pdaxrom/pico-hd6303/hw/pico-hd6303.brd

## EAGLE design hw/pico-hd6303.brd (2023-06-01)

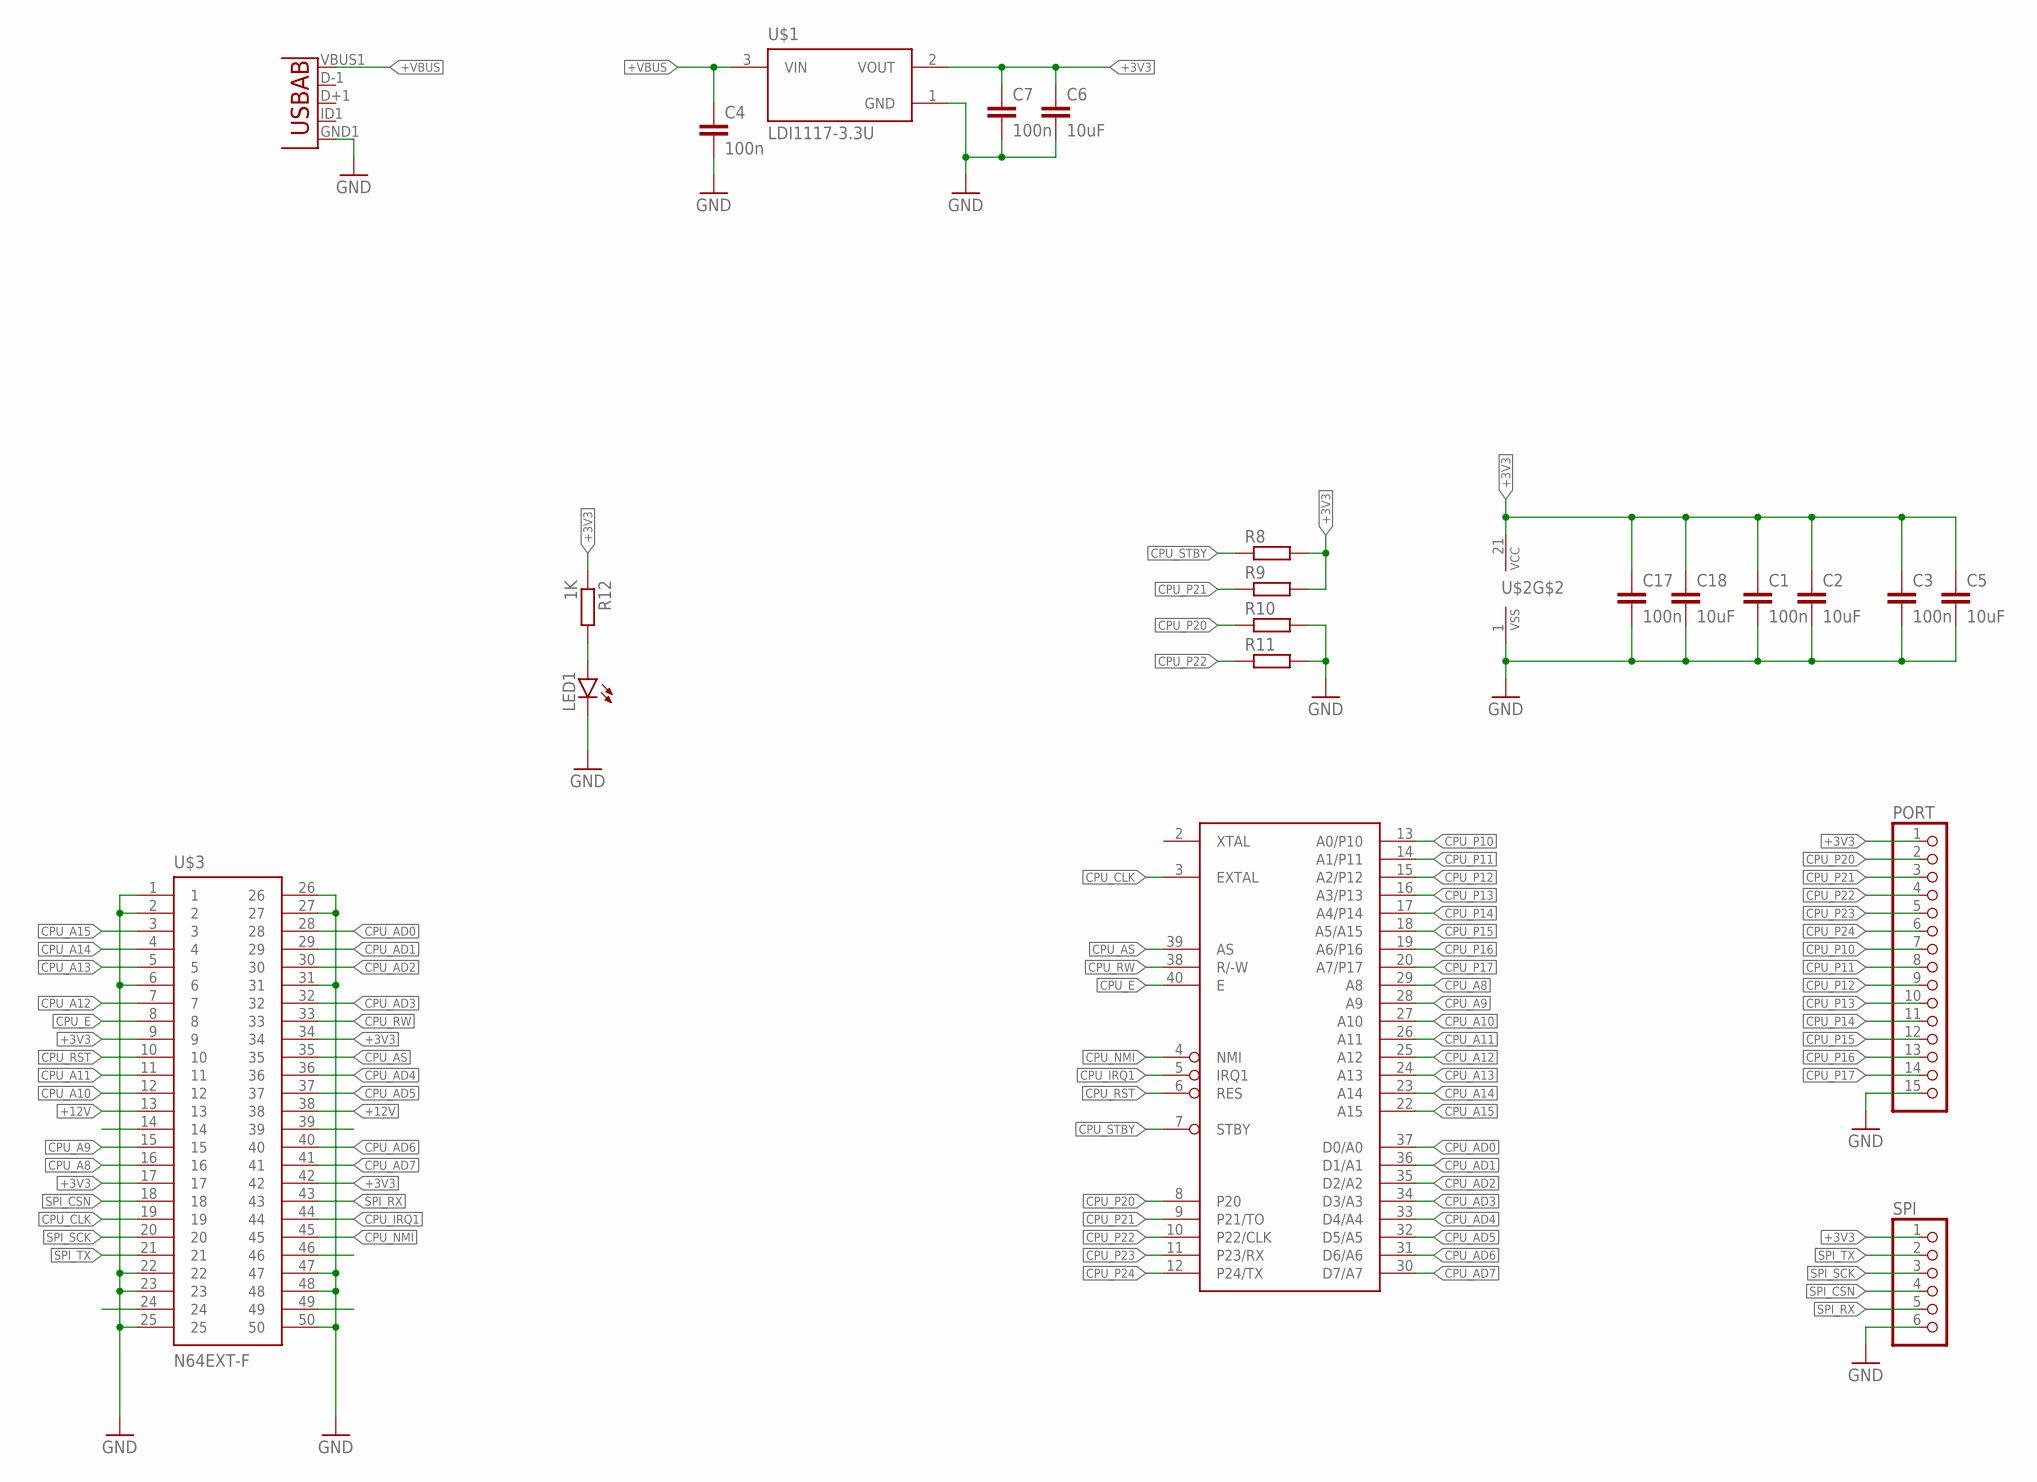
[picture p1: schematic pico-hd6303.sch]

Parts:
C1, C3, C17: 100n; C0603
C2, C5, C6, C18: 10uF; C0805
C4, C7: 100n; C0402
LED1: LED5MM
PORT: PINHD-1X15; 1X15
R8, R9, R10, R11: R-EU_R0603; R0603
R12: 1K; R0603
SPI: PINHD-1X6; 1X06
U2: USB""; USB-MICRO-SMD
U$1: LDI1117-3.3U
U$2: HD63B03PRP; DIL40
U$3: N64EXT-F; N64F

Connections:
+3V3: C1.1, C2.1, C3.1, C5.1, C6.1, C7.1, C17.1, C18.1, PORT.1, R8.2, R9.2, R12.1, SPI.1, U$1.2 (VOUT), U$2.21 (VCC), U$3.9, U$3.17, U$3.34, U$3.42
+12V: U$3.13, U$3.38
+VBUS: C4.1, U2.VBUS1 (VBUS), U$1.3 (VIN)
CPU_A8: U$2.29 (A8), U$3.16
CPU_A9: U$2.28 (A9), U$3.15
CPU_A10: U$2.27 (A10), U$3.12
CPU_A11: U$2.26 (A11), U$3.11
CPU_A12: U$2.25 (A12), U$3.7
CPU_A13: U$2.24 (A13), U$3.5
CPU_A14: U$2.23 (A14), U$3.4
CPU_A15: U$2.22 (A15), U$3.3
CPU_AD0: U$2.37 (D0/A0), U$3.28
CPU_AD1: U$2.36 (D1/A1), U$3.29
CPU_AD2: U$2.35 (D2/A2), U$3.30
CPU_AD3: U$2.34 (D3/A3), U$3.32
CPU_AD4: U$2.33 (D4/A4), U$3.36
CPU_AD5: U$2.32 (D5/A5), U$3.37
CPU_AD6: U$2.31 (D6/A6), U$3.40
CPU_AD7: U$2.30 (D7/A7), U$3.41
CPU_AS: U$2.39 (AS), U$3.35
CPU_CLK: U$2.3 (EXTAL), U$3.19
CPU_E: U$2.40 (E), U$3.8
CPU_IRQ1: U$2.5 (IRQ1), U$3.44
CPU_NMI: U$2.4 (NMI), U$3.45
CPU_P10: PORT.7, U$2.13 (A0/P10)
CPU_P11: PORT.8, U$2.14 (A1/P11)
CPU_P12: PORT.9, U$2.15 (A2/P12)
CPU_P13: PORT.10, U$2.16 (A3/P13)
CPU_P14: PORT.11, U$2.17 (A4/P14)
CPU_P15: PORT.12, U$2.18 (A5/A15)
CPU_P16: PORT.13, U$2.19 (A6/P16)
CPU_P17: PORT.14, U$2.20 (A7/P17)
CPU_P20: PORT.2, R10.1, U$2.8 (P20)
CPU_P21: PORT.3, R9.1, U$2.9 (P21/TO)
CPU_P22: PORT.4, R11.1, U$2.10 (P22/CLK)
CPU_P23: PORT.5, U$2.11 (P23/RX)
CPU_P24: PORT.6, U$2.12 (P24/TX)
CPU_RST: U$2.6 (RES), U$3.10
CPU_RW: U$2.38 (R/-W), U$3.33
CPU_STBY: R8.1, U$2.7 (STBY)
GND: C1.2, C2.2, C3.2, C4.2, C5.2, C6.2, C7.2, C17.2, C18.2, LED1.K (C), PORT.15, R10.2, R11.2, SPI.6, U2.GND1 (GND), U$1.1 (GND), U$2.1 (VSS), U$3.1, U$3.2, U$3.6, U$3.22, U$3.23, U$3.25, U$3.26, U$3.27, U$3.31, U$3.47, U$3.48, U$3.50
unnamed: LED1.A, R12.2
SPI_CSN: SPI.4, U$3.18
SPI_RX: SPI.5, U$3.43
SPI_SCK: SPI.3, U$3.20
SPI_TX: SPI.2, U$3.21

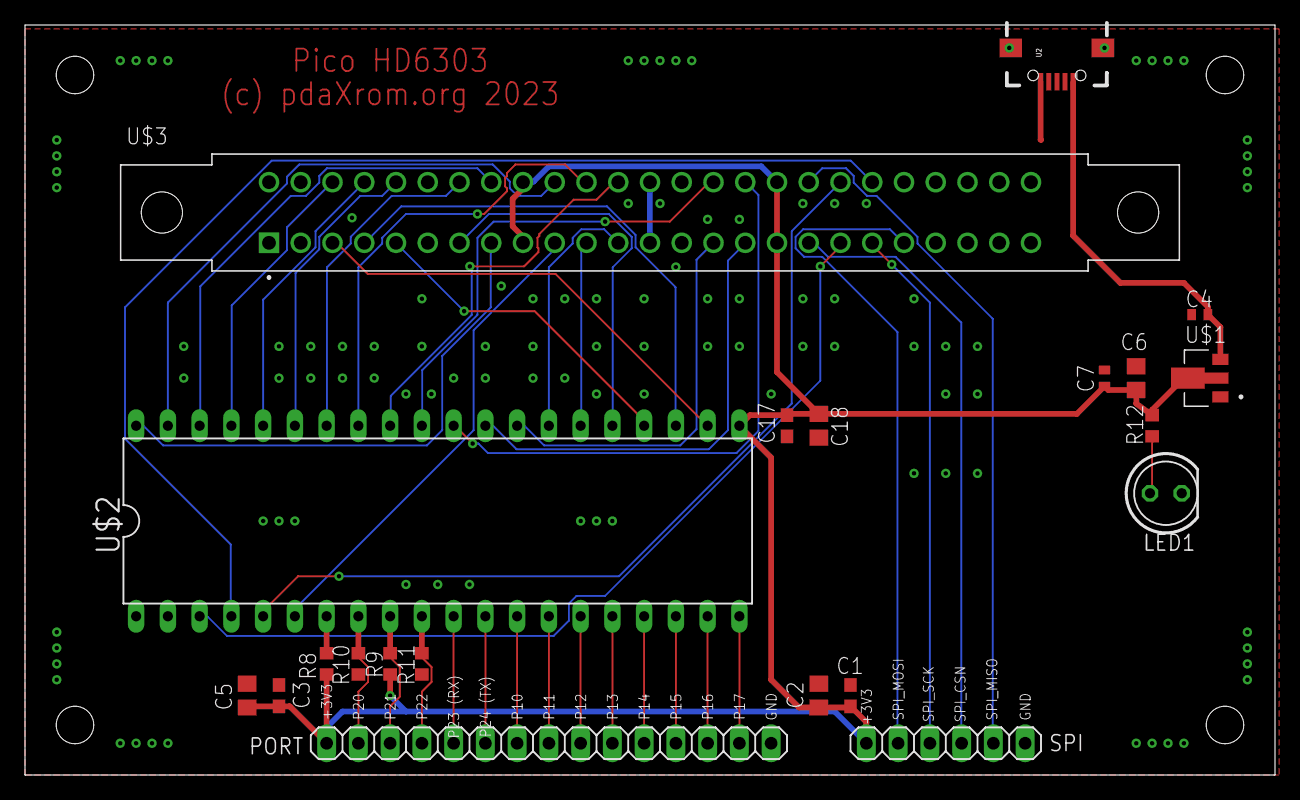
[picture p2: board pico-hd6303.brd from above]

Board: 2 copper layers, 100.0 x 60.0 mm, 21 parts (0 on the bottom side), 46 nets.
