pdaxrom/pico-hd6303/hardware.h

#pragma once

//
// UART
//

#define HW_UART_DATA	0xE6B8
#define HW_UART_CONFIG	0xE6B9
#define HW_UART_STATUS	0xE6B9
#define HW_UART_PRESCALER 0xE6BA

#define HW_UART_RRD	0x01
#define HW_UART_TRD	0x8
//#define HW_UART_RIE	0x10
//#define HW_UART_TIE	0x20
//#define HW_UART_RIQ	0x40
//#define HW_UART_TIQ	0x80
