pdaxrom/pico-hd6303/(commit log)

2023-05-11 use usb cdc as uart, added uart bootrom
2023-05-12 mapping real hardware uart to cpu bus to get working CPU on 2MHz
2023-05-12 updated pins to use gp16/gp17 as UART0
2023-05-12 missed power pins for minimal configuration
    [hd6303.h]
2023-06-01 pico hd6303 hardware board reused n64cart as cpu control logic, i/o and rom/ram
    [pico-hd6303.brd, pico-hd6303.sch]
